VID-PRO/BambuTagger-AMS/3DPrints/BambuTagger-AMS.3mf

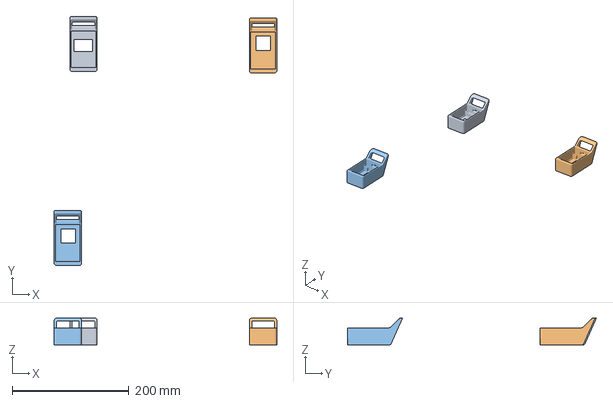
[picture p8: CAD file, 2026-06-07]
3DPrints/BambuTagger-AMS.3mf
381.9 x 427.1 x 46.1 mm
BambuTagger-AMS
BambuTagger-AMS-C x 2
