VID-PRO/BambuTagger-AMS/config.h

#ifndef CONFIG_H
#define CONFIG_H

#include <Arduino.h>
#include <Preferences.h>

#define FIRMWARE_VERSION "1.0.9"
#define OTA_REPO "VID-PRO/BambuTagger-AMS"

#define NUM_SLOTS 4

// --- Pin Assignments ---
// SPI Bus
#define SPI_MOSI 23
#define SPI_MISO 19
#define SPI_SCK  18

// RC522 CS (SS) pins
const uint8_t SS_PINS[NUM_SLOTS]  = {13, 12, 14, 27};
// RC522 RST pins
const uint8_t RST_PINS[NUM_SLOTS] = {26, 25, 33, 32};
// WS2812 LED daisy chain (single data pin, 4 LEDs in series)
#define LED_DATA_PIN   15
#define LED_COUNT      4
#define LED_BRIGHTNESS 64

// I2C OLED (128x64 SSD1306)
#define I2C_SDA 21
#define I2C_SCL 22
#define OLED_ADDR 0x3C

// --- RFID Settings ---
#define RFID_POLL_INTERVAL_MS  100
#define RFID_DEBOUNCE_MS       500
#define NTAG_PAGE_SIZE         4
#define NTAG_USER_START_PAGE   4
#define NTAG_MAX_PAGES         231

// --- Spool Info Structure ---
struct SpoolInfo {
  bool present;
  char uid[16];
  char materialType[32];
  char detailedType[256];
  char color[16];
  char colorHex[9];
  uint16_t remainingGrams;
  uint16_t totalGrams;
  uint16_t nozzleTempMin;
  uint16_t nozzleTempMax;
  char batchNumber[32];
  char manufacturer[32];
  uint32_t lastSeen;
  bool tagReadSuccess;
};

// --- System Configuration ---
struct SystemConfig {
  char wifiSSID[32];
  char wifiPassword[64];
  char printerIP[16];
  uint16_t printerPort;
  char printerAccessCode[48];
  char printerSerial[32];
  char deviceName[32];
  uint8_t amsUnit;  // 0=A, 1=B, 2=C, 3=D
  bool mqttEnabled;
  bool mqttUseTLS;
  uint32_t mqttUpdateIntervalMs;
  char mqttTopicPrefix[64];
};

// --- Default Configuration ---
inline SystemConfig getDefaultConfig() {
  SystemConfig cfg;
  strcpy(cfg.wifiSSID, "");
  strcpy(cfg.wifiPassword, "");
  strcpy(cfg.printerIP, "192.168.1.100");
  cfg.printerPort = 8883;
  strcpy(cfg.printerAccessCode, "");
  strcpy(cfg.printerSerial, "");
  strcpy(cfg.deviceName, "BambuTagger-AMS");
  cfg.amsUnit = 0;
  cfg.mqttEnabled = false;
  cfg.mqttUseTLS = false;
  cfg.mqttUpdateIntervalMs = 3000;
  strcpy(cfg.mqttTopicPrefix, "device");
  return cfg;
}

// --- Persistent Config Helpers ---
inline void loadConfig(SystemConfig &cfg) {
  Preferences prefs;
  prefs.begin("bambu-ams", true);
  cfg = getDefaultConfig();
  if (prefs.isKey("wifiSSID")) prefs.getString("wifiSSID", cfg.wifiSSID, sizeof(cfg.wifiSSID));
  if (prefs.isKey("wifiPwd")) prefs.getString("wifiPwd", cfg.wifiPassword, sizeof(cfg.wifiPassword));
  if (prefs.isKey("printerIP")) prefs.getString("printerIP", cfg.printerIP, sizeof(cfg.printerIP));
  cfg.printerPort = prefs.getUShort("printerPort", cfg.printerPort);
  if (prefs.isKey("accCode")) prefs.getString("accCode", cfg.printerAccessCode, sizeof(cfg.printerAccessCode));
  if (prefs.isKey("printerSN")) prefs.getString("printerSN", cfg.printerSerial, sizeof(cfg.printerSerial));
  if (prefs.isKey("devName")) prefs.getString("devName", cfg.deviceName, sizeof(cfg.deviceName));
  cfg.mqttEnabled = prefs.getBool("mqttEn", cfg.mqttEnabled);
  cfg.mqttUseTLS = prefs.getBool("mqttTLS", cfg.mqttUseTLS);
  cfg.mqttUpdateIntervalMs = prefs.getULong("mqttInt", cfg.mqttUpdateIntervalMs);
  cfg.amsUnit = prefs.getUChar("amsUnit", cfg.amsUnit);
  prefs.end();
}

inline void saveConfig(const SystemConfig &cfg) {
  Preferences prefs;
  prefs.begin("bambu-ams", false);
  prefs.putString("wifiSSID", cfg.wifiSSID);
  prefs.putString("wifiPwd", cfg.wifiPassword);
  prefs.putString("printerIP", cfg.printerIP);
  prefs.putUShort("printerPort", cfg.printerPort);
  prefs.putString("accCode", cfg.printerAccessCode);
  prefs.putString("printerSN", cfg.printerSerial);
  prefs.putString("devName", cfg.deviceName);
  prefs.putBool("mqttEn", cfg.mqttEnabled);
  prefs.putBool("mqttTLS", cfg.mqttUseTLS);
  prefs.putULong("mqttInt", cfg.mqttUpdateIntervalMs);
  prefs.putUChar("amsUnit", cfg.amsUnit);
  prefs.end();
}

#endif
