VID-PRO/BambuTagger-AMS/display_manager.h

#ifndef DISPLAY_MANAGER_H
#define DISPLAY_MANAGER_H

#include <Arduino.h>
#include <Wire.h>
#include <Adafruit_GFX.h>
#include <Adafruit_SSD1306.h>
#include "config.h"
#include "bambu_printer.h"
#include "splash_logo.h"

#define SCREEN_WIDTH  128
#define SCREEN_HEIGHT 64
#define OLED_RESET    -1

class DisplayManager {
public:
  void begin(const char* deviceName);
  void update(const SpoolInfo slots[NUM_SLOTS], bool wifiConnected,
              bool mqttConnected, BambuPrinter* printer = nullptr,
              uint8_t amsUnit = 0, float temp = -99, float humidity = -1);
  void showMessage(const char* line1, const char* line2 = nullptr,
                   const char* line3 = nullptr, const char* line4 = nullptr);
  void showOtaProgress(const char* line1, const char* line2 = nullptr,
                       const char* line3 = nullptr, int pct = -1);
  void showBootScreen();

private:
  void drawStatusBar(bool wifiConnected);
  void drawSlotGrid(const SpoolInfo slots[NUM_SLOTS]);
  void drawPrinterSlots(BambuPrinter* printer, uint8_t amsUnit);
  void drawFooter(bool mqttConnected, bool printerOnline, float temp = -99, float humidity = -1);

  Adafruit_SSD1306* display;
  char deviceName[32];
  unsigned long lastUpdate;
};

#endif
