VID-PRO/BambuTagger-AMS/(commit log)

2026-05-26 tags accepted by printer
2026-05-28 fixed led colors
